YuElvin/stm32_canbus/CANbus_code/Core/Src/main.c

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
/* Includes ------------------------------------------------------------------*/
#include "main.h"
#include "FreeRTOS.h"
#include "cmsis_os2.h"
#include "fatfs.h"
#include "fdcan.h"
#include "lwip.h"
#include "quadspi.h"
#include "sdmmc.h"
#include "usart.h"
#include "gpio.h"

/* USER CODE BEGIN Includes */
#include <stdio.h>
#include <string.h>
#include "FreeRTOS.h"
#include "task.h"
#include "w25qxx.h"
#include "sd_verify.h"
/* USER CODE END Includes */


void SystemClock_Config(void);
static void MPU_Config(void);
void MX_FREERTOS_Init(void);
/**
  * @brief  The application entry point.
  * @retval int
  */
int main(void)
{

  /* USER CODE BEGIN 1 */
  /* Explicitly disable UNALIGN_TRP so that Cortex-M7 handles unaligned
     word access in hardware (Normal memory only). LwIP frequently does
     32-bit access at byte-aligned addresses (IP header in pbuf etc.)
     and we use SMEMCPY override + non-cacheable D2 SRAM, so unaligned
     access must work. */
  SCB->CCR &= ~SCB_CCR_UNALIGN_TRP_Msk;
  __DSB();
  __ISB();
  /* USER CODE END 1 */

  /* MPU Configuration--------------------------------------------------------*/
  MPU_Config();

  /* MCU Configuration--------------------------------------------------------*/

  /* Reset of all peripherals, Initializes the Flash interface and the Systick. */
  HAL_Init();

  /* Configure the system clock */
  SystemClock_Config();

  /* Initialize all configured peripherals */
  MX_GPIO_Init();
  /* MX_FDCAN1_Init(); */     /* Disabled for ETH-only test */
  MX_QUADSPI_Init();
  /* MX_SDMMC1_SD_Init(); */   /* FatFs calls BSP_SD_Init() internally */
  MX_USART2_UART_Init();
  MX_FATFS_Init();
  /* USER CODE BEGIN 2 */
  /* MX_SDMMC1_SD_Init() is commented out to avoid duplicate HAL_SD_Init() call
     (FatFs calls BSP_SD_Init internally). But we still need to set Instance
     and call MspInit so that SDMMC GPIO/clock/PLL are configured. Without
     this, HAL_SD_MspInit's Instance==SDMMC1 check fails and the peripheral
     is left unpowered → NULL pointer dereference in HAL_SD_InitCard.
     Also override BusWide to 1B: 4-bit mode CMD6 always fails on this board
     (D3/PC11 or CMD/PD2 signal quality issue), falling back wastes ~2s every boot. */
  extern SD_HandleTypeDef hsd1;
  hsd1.Instance = SDMMC1;
  hsd1.Init.BusWide = SDMMC_BUS_WIDE_1B;
  /* Force-reset SDMMC1 to clear stale IDMA state from debug resets.
     Without this, a previous session's IDMACTRL/IDMABASE0 may remain
     configured, causing phantom AXI writes → IMPRECISE HardFault. */
  __HAL_RCC_SDMMC1_FORCE_RESET();
  __HAL_RCC_SDMMC1_RELEASE_RESET();
  HAL_SD_MspInit(&hsd1);
  SD_Detect_GPIO_Init();
  /* SD_Verify() must run after FreeRTOS scheduler starts (sd_diskio uses
     RTOS message queue for DMA completion). Moved to a task in freertos.c. */
  /* USER CODE END 2 */

  /* Init scheduler */
  osKernelInitialize();  /* Call init function for freertos objects (in cmsis_os2.c) */
  MX_FREERTOS_Init();

  /* Start scheduler */
  osKernelStart();

  /* We should never get here as control is now taken by the scheduler */

  /* Infinite loop */
  /* USER CODE BEGIN WHILE */
  while (1)
  {
    /* USER CODE END WHILE */

    /* USER CODE BEGIN 3 */
  }
  /* USER CODE END 3 */
}

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
/* USER CODE BEGIN 4 */
extern UART_HandleTypeDef huart2;

static void uart_print(const char *s)
{
  HAL_UART_Transmit(&huart2, (uint8_t *)s, strlen(s), 200);
}

void vAssertCalled(const char *file, uint32_t line)
{
  char buf[80];
  taskDISABLE_INTERRUPTS();
  sprintf(buf, "\r\n[ASSERT] %s:%lu\r\n", file, line);
  uart_print(buf);
  for(;;) {}
}
/* USER CODE END 4 */

 /* MPU Configuration */

void MPU_Config(void)
{
  MPU_Region_InitTypeDef MPU_InitStruct = {0};

  /* Disables the MPU */
  HAL_MPU_Disable();

  /** Initializes and configures the Region and the memory to be protected
  */
  MPU_InitStruct.Enable = MPU_REGION_ENABLE;
  MPU_InitStruct.Number = MPU_REGION_NUMBER0;
  MPU_InitStruct.BaseAddress = 0x30000000;
  MPU_InitStruct.Size = MPU_REGION_SIZE_256KB;
  MPU_InitStruct.SubRegionDisable = 0x0;
  MPU_InitStruct.TypeExtField = MPU_TEX_LEVEL1;
  MPU_InitStruct.AccessPermission = MPU_REGION_FULL_ACCESS;
  MPU_InitStruct.DisableExec = MPU_INSTRUCTION_ACCESS_DISABLE;
  /* Memory attributes: TEX=001, C=0, B=0, S=0 → Normal Outer/Inner Non-Cacheable.
     CubeMX default (TEX=001, C=0, B=1) is "Implementation-defined" per ARMv7-M
     spec, which on STM32H7 behaves Device-like: forbids unaligned access and
     traps cache maintenance ops. Correct Normal-NC encoding requires B=0. */
  MPU_InitStruct.IsShareable = MPU_ACCESS_NOT_SHAREABLE;
  MPU_InitStruct.IsCacheable = MPU_ACCESS_NOT_CACHEABLE;
  MPU_InitStruct.IsBufferable = MPU_ACCESS_NOT_BUFFERABLE;

  HAL_MPU_ConfigRegion(&MPU_InitStruct);

  /** Initializes and configures the Region and the memory to be protected
  */
  MPU_InitStruct.Number = MPU_REGION_NUMBER1;
  MPU_InitStruct.BaseAddress = 0x24000000;
  MPU_InitStruct.Size = MPU_REGION_SIZE_512KB;
  MPU_InitStruct.DisableExec = MPU_INSTRUCTION_ACCESS_ENABLE;
  MPU_InitStruct.IsShareable = MPU_ACCESS_NOT_SHAREABLE;
  MPU_InitStruct.IsCacheable = MPU_ACCESS_CACHEABLE;

  HAL_MPU_ConfigRegion(&MPU_InitStruct);
  /* Enables the MPU */
  HAL_MPU_Enable(MPU_PRIVILEGED_DEFAULT);

}

/**
  * @brief  Period elapsed callback in non blocking mode
  * @note   This function is called  when TIM6 interrupt took place, inside
  * HAL_TIM_IRQHandler(). It makes a direct call to HAL_IncTick() to increment
  * a global variable "uwTick" used as application time base.
  * @param  htim : TIM handle
  * @retval None
  */
void HAL_TIM_PeriodElapsedCallback(TIM_HandleTypeDef *htim)
{
  if (htim->Instance == TIM6)
  {
    HAL_IncTick();
  }
}

/**
  * @brief  This function is executed in case of error occurrence.
  * @retval None
  */
void Error_Handler(void)
{
  /* USER CODE BEGIN Error_Handler_Debug */
  char buf[48];
  __disable_irq();
  sprintf(buf, "\r\n[ERROR_HANDLER] LR=0x%08lX\r\n",
          (uint32_t)__builtin_return_address(0));
  HAL_UART_Transmit(&huart2, (uint8_t *)buf, strlen(buf), 200);
  while (1) {}
  /* USER CODE END Error_Handler_Debug */
}
#ifdef USE_FULL_ASSERT
/**
  * @brief  Reports the name of the source file and the source line number
  *         where the assert_param error has occurred.
  * @param  file: pointer to the source file name
  * @param  line: assert_param error line source number
  * @retval None
  */
void assert_failed(uint8_t *file, uint32_t line)
{
  /* USER CODE BEGIN 6 */
  /* User can add his own implementation to report the file name and line number,
     ex: printf("Wrong parameters value: file %s on line %d\r\n", file, line) */
  /* USER CODE END 6 */
}
#endif /* USE_FULL_ASSERT */
