YuElvin/stm32_canbus/CANbus_code/CANbus_code.ioc

Mcu.UserName=STM32H750VBTx
PA1.Signal=ETH_REF_CLK
PA2.Signal=ETH_MDIO
PA7.Signal=ETH_CRS_DV
PB10.Signal=QUADSPI_BK1_NCS
PB11.Signal=ETH_TX_EN
PB12.Signal=ETH_TXD0
PB13.Signal=ETH_TXD1
PB2.Signal=QUADSPI_CLK
PC1.Signal=ETH_MDC
PC10.Signal=SDMMC1_D2
PC11.Signal=SDMMC1_D3
PC12.Signal=SDMMC1_CK
PC4.Signal=ETH_RXD0
PC5.Signal=ETH_RXD1
PC8.Signal=SDMMC1_D0
PC9.Signal=SDMMC1_D1
PD0.Signal=FDCAN1_RX
PD1.Signal=FDCAN1_TX
PD11.Signal=QUADSPI_BK1_IO0
PD12.Signal=QUADSPI_BK1_IO1
PD13.Signal=QUADSPI_BK1_IO3
PD2.Signal=SDMMC1_CMD
PD5.Signal=USART2_TX
PD6.Signal=USART2_RX
PE2.Signal=QUADSPI_BK1_IO2
PE7.Signal=GPIO_Output
PE8.Signal=GPIO_Output
