YuElvin/stm32_canbus/CANbus_code/Core/Inc/main.h

#define DBG_LED1_Pin            GPIO_PIN_10
#define DBG_LED1_GPIO_Port      GPIOE
#define DBG_LED2_Pin            GPIO_PIN_11
#define DBG_LED2_GPIO_Port      GPIOE
#define SD_DETECT_Pin           GPIO_PIN_8
#define SD_DETECT_GPIO_Port     GPIOA
