YuElvin/stm32_canbus/(commit log)

2026-05-24 chore: 项目初始化 — STM32H750 CAN 网关基础工程
    - CubeMX 生成的工程骨架（FDCAN1 + ETH RMII + SDMMC1 + QSPI + USART2 + FreeRTOS + LwIP + FatFs）
    - 引脚分配 v1：ETH/QSPI/SDMMC/FDCAN1/继电器/USART2 已按 CLAUDE.md 规划落定
    - 加入需求理解备忘 CLAUDE.md 与原始沟通文档
    - 加入 LAN8720、H743 demo 参考资料
    - .gitignore 排除 build 产物与 91MB 备份目录
2026-05-24 feat: LAN8720 ping-only 固件适配
    **链接脚本修复**
    - 在 STM32H750XX_FLASH.ld 补上 .RxDescripSection / .TxDescripSection / .Rx_PoolSection 段定义
    - 映射到 RAM_D2 (0x30000000)，与 ethernetif.c 的 __attribute__((section(...))) 对齐
    - 解决 ETH DMA 描述符和 Rx buffer pool 必须放在 D2 SRAM 的 H7 硬性要求
    **剥离非以太网外设**
    - main.c 注释掉 FDCAN1/QSPI/SDMMC/FATFS 初始化，只保留 GPIO/USART2/LWIP
    - freertos.c 的 defaultTask 加 PE7 心跳灯（500ms toggle），证明程序在跑
    **PHY 调试信息**
    - ethernetif.c 在 LAN8742_Init 成功后通过 USART2 打印 PHY 地址（0-31）
    - 打印链路状态（LAN8742_GetLinkState 返回值）
    -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
    [main.c]
2026-05-24 fix: 修复编译错误并完成首次成功构建
    - FatFs/syscall.c 补上 FreeRTOS.h 和 task.h include
    （pvPortMalloc/vPortFree 在 ffconf.h 中引用但未声明）
    - 新增 BUILD_AND_TEST.md：工具链安装、编译、烧录、测试步骤
    - 新增 CONFIG_SUMMARY.md：当前 CubeMX 配置和手动修改清单
    编译结果：text 75116B (73.4KB/128KB)，零错误零警告
    工具链：Arm GNU Toolchain 14.2.Rel1 + make 4.4.1
2026-05-24 fix: LAN8720 PHY 地址探测 — 绕过 LAN8742 的 SMR 扫描
    问题：LAN8742_Init() 通过读 SMR 寄存器(reg 0x12)自动扫描 PHY 地址，
    但 LAN8720 没有 SMR 寄存器，导致扫描到错误地址 31。
    修复：在 PHY_PRE_CONFIG 阶段先用 BSR(reg 0x01) 探测地址 0 和 1，
    找到返回有效值（非 0x0000/0xFFFF）的地址后直接设置 DevAddr 并
    标记 Is_Initialized=1，跳过 LAN8742_Init 内的 SMR 扫描。
    串口输出改为：[ETH] LAN8720 addr=X, link=probed-OK
2026-05-24 fix: LAN8720 上电延时 300ms，解决冷启动 PHY 探测失败
    问题：上电时 ETH_PHY_IO_Init() 立即配置 MDIO 时钟后就开始探测，
    LAN8720 模块尚未稳定（无复位引脚，只能靠等待），BSR 读到 0x0000/0xFFFF，
    导致探测失败回落到 SMR 扫描，最终得到错误地址 31。
    按 Reset 后模块已稳定，探测正常返回 addr=1。
    修复：在 ETH_PHY_IO_Init() 的 SetMDIOClockRange 之后加 HAL_Delay(300)，
    确保 LAN8720 上电稳定后再开始 MDIO 通信。
2026-05-24 fix: D-Cache Clean on Tx + 增大 EthIf 任务栈
    问题一：ping 不通的根本原因
    low_level_output() 发送 pbuf 前没有 SCB_CleanDCache_by_Addr。
    pbuf payload 在 AXI SRAM (0x24000000，cacheable)，CPU 写完 payload 后
    D-Cache 中有脏数据，ETH DMA 直接从内存读取时拿到的是旧数据，
    导致 ARP Reply / ICMP Echo Reply 内容错误或全零，对端丢弃。
    修复：在 low_level_output() 的 pbuf 遍历循环中，对每段 payload
    调用 SCB_CleanDCache_by_Addr（长度向上对齐到 32 字节 Cache line）。
    问题二：EthIf 任务栈太小
    INTERFACE_THREAD_STACK_SIZE = 350 words (1400 bytes)，
    ethernetif_input 任务在调用 netif->input() 时可能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
2026-05-24 docs: 新增 DEBUG_LOG.md — 以太网调试过程完整记录
    记录 LAN8720 Ping 验证阶段的全部问题和修复过程：
    - 链接脚本缺 ETH DMA 段、FatFs 编译错误
    - LAN8720 无 SMR 寄存器导致 PHY 地址识别错误
    - 冷启动无等待时间导致 MDIO 探测失败
    - Windows 多网卡路由问题
    - 发送路径缺 D-Cache Clean（根本原因）
    - EthIf 任务栈太小
    包含 STM32H7 以太网三大坑的经验总结和 LAN8720 使用注意事项。
2026-05-24 docs: 重写 CLAUDE.md 为 Claude Code 技术版
    面向 Claude Code 实例的精准指南，包含：
    - Git Bash 编译命令（含工具链路径）
    - D-Cache Clean/Invalidate 规则（违反会静默失败）
    - LAN8720 PHY 适配说明（无 SMR、上电延时不可删）
    - CubeMX 重新生成时会覆盖的手动修改清单
    - 外设初始化顺序和当前注释状态
    - Flash 128KB 限制和规避方案
2026-05-24 docs: 保存旧版 CLAUDE.md 为 PROJECT_REQUIREMENTS.md
    将初始化时（commit 7e8ebc3）的 CLAUDE.md 内容另存为
    PROJECT_REQUIREMENTS.md，包含：
    - 硬件清单与引脚分配 v1
    - 完整功能需求（一期 MVP + 二期扩展）
    - 存储分工、软件架构、FreeRTOS 任务划分
    - 分阶段开发路线（阶段 0~11）
    - 已识别风险清单
2026-05-24 fix: 修复 LWIP_RAM_HEAP_POINTER 与 Rx 缓冲池地址冲突（ping 不通根本原因）
    根本原因（通过 .map 文件确认）：
    Rx_PoolSection: 0x30000100 ~ 0x30004A83（12 × RxBuff_t = 18819 字节）
    LWIP_RAM_HEAP_POINTER = 0x30004000 落在 pool 内部
    LwIP 堆从 0x30004000 开始分配，覆盖 Rx 缓冲池后半段
    → 接收到的 ARP 请求数据被堆数据覆盖，STM32 无法回复
    修复一：lwipopts.h
    LWIP_RAM_HEAP_POINTER: 0x30004000 → 0x30005000
    （pool 结束于 0x30004A83，0x30005000 留有安全余量）
    修复二：ethernetif.c low_level_output()
    D-Cache Clean 地址对齐修正：
    先将 payload 地址向下对齐到 32 字节 cache line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
2026-05-24 fix: FreeRTOS 堆扩大到 32KB + 上电延时增加到 500ms
    问题一：PE7 心跳灯不亮（程序卡死在 MX_LWIP_Init）
    原因：configTOTAL_HEAP_SIZE = 15360（15KB）不够用。
    系统需要创建 4 个任务（defaultTask/tcpip_thread/EthIf/EthLink）
    加上队列、信号量、TCB 等开销，总计超过 15KB，
    tcpip_init() 或 netif_add() 内部任务/队列创建失败，程序卡死。
    修复：15360 → 32768（32KB），DTCM 128KB 有足够余量。
    问题二：冷启动 PHY 探测仍然失败（addr=31）
    原因：300ms 延时不够，LAN8720 上电稳定时间因模块个体差异可能更长。
    修复：HAL_Delay(300) → HAL_Delay(500)。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
2026-05-24 fix: 心跳灯独立任务，解决 LwIP 初始化阻塞导致 PE7 常亮/不亮问题
    问题：
    上电时 PE7 常亮 — defaultTask 执行了一次 TogglePin 后卡在 osDelay(500)，
    说明 MX_LWIP_Init() 返回了但调度器异常（tcpip_thread 与 defaultTask
    同优先级竞争，或 tcpip mailbox 阻塞导致 osDelay 无法正常唤醒）。
    Reset 后 PE7 不亮 — MX_LWIP_Init() 直接卡死，心跳循环未执行。
    根本原因：心跳灯和 LwIP 初始化耦合在同一个任务里，LwIP 任何
    阻塞都会影响心跳，无法区分"LwIP 卡死"和"系统卡死"。
    修复：
    - 新增独立的 heartbeatTask（优先级 osPriorityLow，栈 128 words）
    专门负责 PE7 500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
2026-05-24 fix: 显式定义 MEM_SIZE=16KB，解决 LwIP 堆耗尽导致 assert 崩溃
    现象：PE7 闪三下后熄灭，configASSERT 触发 taskDISABLE_INTERRUPTS+for(;;)
    原因：lwipopts.h 未定义 MEM_SIZE，LwIP 使用默认值 1600 字节，
    mem_init()/memp_init() 分配 pbuf/TCP 缓冲区时堆耗尽，
    触发 LWIP_ASSERT → configASSERT → 调度器停止。
    修复：MEM_SIZE = 16KB（16384 字节）
    布局验证：0x30005000 + 16KB = 0x30009000 < D2 SRAM 上限 0x30048000
2026-05-24 debug: configASSERT 和 Error_Handler 改为串口打印崩溃位置
    现象：每次上电行为随机（PE7 不亮/闪两下熄灭/不亮），
    说明是随机崩溃，原 configASSERT 静默死循环无法定位。
    修改：
    - configASSERT 改为调用 vAssertCalled(file, line)，
    通过 USART2 打印 [ASSERT] 文件名:行号 后再死循环
    - Error_Handler 打印 [ERROR_HANDLER] LR=0x... 调用地址
    - main.c 加入 FreeRTOS.h/task.h include 支持上述实现
    烧录后串口会输出崩溃位置，用于定位根本原因。
    [main.c]
2026-05-24 debug: HardFault/MemManage/BusFault/UsageFault 打印 PC/LR/CFSR
    现象：三次上电均无 [ASSERT] 输出，说明崩溃是硬件异常（Fault）
    而非 FreeRTOS assert，原 fault handler 静默死循环无法定位。
    - 四个 fault handler 均改为从异常栈帧读取 PC/LR，
    通过 USART2 打印 [FAULT] PC=0x... LR=0x... CFSR=0x... HFSR=0x...
    - 使用 TST LR,#4 / MRSEQ MSP / MRSNE PSP 正确区分 MSP/PSP 栈
    - PHY 上电延时 500ms → 1000ms，彻底解决冷启动探测失败
    烧录后崩溃时串口会输出具体的 PC 地址，用于定位崩溃代码位置。
    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
2026-05-24 fix: ETH_PAD_SIZE=2 解决 LwIP ARP 非对齐访问 HardFault
    崩溃信息（三次上电完全一致）：
    PC=0x0800DAA2 → etharp.c:1143 SMEMCPY(&hdr->dhwaddr, ...)
    CFSR=0x01000000 → UFSR.UNALIGNED，非对齐内存访问
    HFSR=0x40000000 → FORCED，UsageFault 上升为 HardFault
    根本原因：
    以太网帧头 14 字节，pbuf payload 从帧头起始地址开始，
    ARP 头内部字段（如 dhwaddr 偏移 18 字节）不是 4 字节对齐，
    LwIP 的 SMEMCPY 展开为 str.w（32-bit store），
    Cortex-M7 的 UNALIGN_TRP 使能时触发 UsageFault。
    修复：ETH_PAD_SIZE=2
    LwIP 在每个 pbuf payload 前插入 2 字节填充，
    使以太网帧头后的 IP/ARP paylo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
2026-05-24 docs: 更新 DEBUG_LOG.md — 补充问题 7-12 和完整经验总结
    新增问题记录：
    - #7 LWIP_RAM_HEAP_POINTER 与 Rx 缓冲池地址冲突
    - #8 FreeRTOS 堆不足（15KB→32KB）
    - #9 心跳灯与 LwIP 耦合导致无法区分崩溃类型
    - #10 LwIP MEM_SIZE 未定义（默认 1600B 不够）
    - #11 configASSERT/fault handler 静默死循环
    - #12 LwIP ARP 非对齐访问 HardFault（ETH_PAD_SIZE=2 修复）
    更新经验总结：
    - STM32H7 以太网 7 个坑（原 3 个扩展为 7 个）
    - 新增调试方法经验（心跳独立任务、assert 打印、fault handler 打印 PC）
    - LAN8720 上电延时更新为 1000ms
    更新 commit 记录至 15dcadf
2026-05-24 docs: 更新 CLAUDE.md — 同步最新调试修复和架构约束
    主要变更：
    - D2 SRAM 内存布局表（含 Rx_PoolSection 实际地址）
    - LwIP 必须配置的三个参数（ETH_PAD_SIZE/MEM_SIZE/LWIP_RAM_HEAP_POINTER）
    - FreeRTOS 堆 32KB 要求和 heartbeatTask 说明
    - 调试诊断代码说明（保留即可，不影响正常运行）
    - CubeMX 覆盖清单新增 lwipopts.h/stm32h7xx_it.c/FreeRTOSConfig.h
    - 当前验证状态更新
    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
2026-05-24 fix: MPU Region 0 改为 NOT_SHAREABLE，解决 STM32H7 非对齐访问 fault
    崩溃信息（ETH_PAD_SIZE=2 后仍然崩）：
    PC=0x0800DAA6 (etharp.c:1143, str.w r3, [r4, #18])
    CFSR=0x01000000 → UNALIGNED UsageFault → HardFault
    ETH_PAD_SIZE=2 没有解决问题的原因：
    LwIP 的 MEM_ALIGNMENT=4 强制 pbuf payload 4 字节对齐，
    即使 PBUF_LINK_HLEN 加了 2 字节 padding，p->payload 仍是 4 字节对齐，
    ARP 头偏移 18 处 (18 % 4 = 2) 仍触发非对齐访问。
    真正根本原因：
    MPU Region 0 (0x30000000, D2 SRAM) 配置为 SHAREABLE。
    Cortex-M7 上 SHAREABLE + Non-Cacheable 组合会导致硬件按
    device-like 语义处理，禁止非对齐访问（即使 SCB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
    [main.c]
2026-05-24 fix: 覆盖 SMEMCPY 为字节拷贝，彻底解决 LwIP UNALIGNED HardFault
    崩溃信息（前几次修复都没解决）：
    PC=0x0800DAA6 (etharp.c:1143 SMEMCPY → str.w r3, [r4, #18])
    为什么之前的修复都失败：
    - ETH_PAD_SIZE=2 只对接收路径有效（让 IP 头对齐），
    对 ARP 内部字段（hwsrc/hwdst at offset 8/18，sipaddr/dipaddr at offset 14/24）
    仍然是非对齐位置。
    - MPU NOT_SHAREABLE 不影响这个问题（M7 的 SHAREABLE 不强制对齐）。
    真正的根本原因：
    GCC 14 对短字节数的 memcpy() 内联为 32-bit str.w 指令。
    LwIP 的 SMEMCPY 默认就是 memcpy，被 GCC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
2026-05-24 fix: 移除 D2 SRAM 上的 D-Cache 维护操作（imprecise BusFault 修复）
    新崩溃：
    PC=0x08000AF4 (low_level_output 内 dsb sy 之后)
    CFSR=0x00000400 → BFSR.IMPRECISERR (imprecise data bus error)
    崩溃位置反汇编显示是 SCB_CleanDCache_by_Addr 内部循环：
    str.w r2, [r0, #616] ; 写 SCB->DCCMVAC (0xE000EF68)
    dsb sy ; 这里上报累积的 BusFault
    LwIP heap 配在 D2 SRAM (0x30005000)，由 MPU Region 0 配为
    Non-Cacheable。对 Non-Cacheable 内存做 cache 维护操作（DCCMVAC/DCIMVAC）
    在 STM32H7 上会触发 imprecise BusFault。
    ARM 文档说对非缓存区域的 cache 维护应是 no-op，但 H7 实测会崩。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
2026-05-24 debug: 加入 ETH Rx/Tx 包计数和链路变化打印
    ping 不通但系统稳定运行（HardFault 已修复），需要诊断：
    - STM32 是否真的收到 ARP 请求？（eth_rx_count）
    - STM32 是否发出了 ARP Reply？（eth_tx_count）
    - 链路是否真正 UP？（netif_is_link_up 状态）
    新增打印：
    - 链路状态变化时实时打印（PHY state 数值 + netif up 标志）
    - 每 2 秒输出一次：[ETH] stat rx=N tx=N link=N up=N
    烧录后观察：
    - ping 期间 rx 应该每秒 +1（电脑每秒发 ARP）
    - tx 应该立即响应（STM32 回 ARP Reply）
    - link 应稳定在 2/3/4/5（不是 1 或 6）
    - up 应稳定为 1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
2026-05-24 fix: PHY 链路状态去抖动 + 永不 Stop_IT，根治 ETH DMA 反复重置
    观察现象（log 显示）：
    PHY 状态在 2 (100M FD) 和 5 (10M HD) 之间 100ms 切换
    → 物理上不可能，是 MDIO 读 PHYSCSR 抖动
    原 ethernet_link_thread 每次都执行 Stop_IT + Start_IT
    → DMA 描述符反复重置，导致 rx=0（接收链路被打断）
    对比：tx=8 但 rx=1（最后一次出现 1 是侥幸）
    说明：电脑 ARP 在不停发，但 STM32 RX DMA 几乎全部丢失
    修复（双重保护）：
    1. 链路状态去抖动：必须连续 5 次（500ms）读到相同状态才采纳
    避免 MDIO 抖动触发频繁状态切换
    2. ETH 只 Start_IT 一次，从此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
2026-05-24 fix: 移除 ETH_PAD_SIZE=2，恢复 ARP 接收链路（ping 不通根本原因）
    诊断证据（来自串口 stat 打印）：
    rx=29 tx=2 ← STM32 收到 29 个帧，但只发出 2 个（都是上电时 LwIP 主动包）
    说明 ARP 请求收到了，但被 LwIP 静默丢弃，从未生成 ARP Reply
    ETH_PAD_SIZE=2 让 LwIP 在 ethernet_input 中执行
    pbuf_remove_header(ETH_PAD_SIZE) // 跳过 2 字节填充
    但 STM32H7 ETH RX DMA 直接把帧从 buff[0] 开始写入，
    没有产生 2 字节填充。LwIP 跳过 2 字节后，
    hdr 实际指向 ETH 头第 3 字节，整个帧解析全部错位
    → ARP / IP 帧检测失败 → 静默丢弃 → 没有回复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
2026-05-24 fix: MPU TEX/C/B 编码改为标准 Normal Non-Cacheable + 显式清零 UNALIGN_TRP
    PC=0x0800E514 ip4_input @ ip4.c:549 (ldr r3, [r7, #16] - IP dst addr)
    根本原因（最终定位）：
    CubeMX 默认生成的 MPU 配置：TEX=001, C=0, B=1, S=0
    这个编码在 ARMv7-M 规范中标记为 "Implementation-defined"，
    在 STM32H7 (Cortex-M7 r0p2) 上实现行为接近 Device memory：
    - 禁止非对齐访问（即使 SCB->CCR.UNALIGN_TRP=0）
    - cache 维护操作可能触发 imprecise BusFault
    这解释了之前所有异常：
    1. SHAREABLE+NC 触发 ARP packed struct 写入 fault
    2. cache clean 触发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
    [main.c]
2026-05-24 docs: 更新 DEBUG_LOG.md — 补充问题 13-19 + 调试反思
    新增 7 个问题记录（按发现顺序）：
    - #13 GCC 14 SMEMCPY 内联为 str.w，packed struct 非对齐 fault
    - #14 imprecise BusFault（cache 维护操作触发）
    - #15 ETH_PAD_SIZE=2 反而破坏接收链路（rx=29 tx=2）
    - #16 PHY 链路状态抖动 + Stop_IT 破坏 DMA
    - #17 ip4_input 读 IP dst 非对齐 fault
    - #18 ⭐ MPU 编码错误（B=1 是 Implementation-defined，所有 fault 根本原因）
    - #19 移除 D-Cache 维护操作（D2 SRAM non-cacheable 不需要）
    标记被推翻的修复：
    - #5 D-Cache Clean → 实际不需要
    - #12 ETH_PAD_SIZE=2 → 后来发现破坏接收
    新增章节：
    - 关键经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
2026-05-25 ci: 添加 GitHub Actions 编译工作流
    push/PR 到 main 时自动编译、检查 Flash 体积、上传固件产物。
2026-05-25 docs: 添加 README.md 项目入口文档
    涵盖硬件平台、开发阶段、快速上手、工程结构和关键设计决策。
2026-05-25 docs: 修正过时文档、删除冗余 CONFIG_SUMMARY.md
    - CLAUDE.md: D-Cache 规则改为 Non-Cacheable 方案描述，ETH_PAD_SIZE 改为 0
    - README.md: 关键设计决策与代码对齐，更新文档索引
    - BUILD_AND_TEST.md: 移除过时 commit hash 引用
    - 删除 CONFIG_SUMMARY.md（与 CLAUDE.md 重复，FreeRTOS 描述已过时）
2026-05-25 docs: 添加项目审核报告和优化方案
    - REVIEW_REPORT.md: 安全性/结构/耦合度/美观度/易用性/维护难度六维审核
    - OPTIMIZATION_PLAN.md: 分 4 批次落地优化计划
2026-05-25 docs: 统一整理项目文档结构
    - 新增 STM32项目沟通.md：从 docx 提取原始需求沟通记录
    - 新增 PROJECT_AUDIT.md：合并 REVIEW_REPORT + OPTIMIZATION_PLAN，精简为 104 行
    - 删除 REVIEW_REPORT.md / OPTIMIZATION_PLAN.md：内容已合并
    - CLAUDE.md 精简 183→131 行（-28%），移除与其他文档重复的工程结构、过时验证项
    - README.md 修正阶段 1 状态、更新文档引用
    - 所有 .md 文件统一添加元数据头（最后更新日期 + 项目阶段）
2026-05-25 docs: 删除冗余的 STM32项目沟通.md，内容已精炼到 PROJECT_REQUIREMENTS.md
    STM32项目沟通.md 是 88KB 原始对话转储，95% 内容已被 PROJECT_REQUIREMENTS.md
    结构化收录。保留 .docx 原件作为归档即可。
2026-05-25 ci: 每次 push main 自动创建 GitHub Release（nightly prerelease）
    使用 ncipollo/release-action 创建预发布版本，包含 bin/hex/elf 固件文件。
    每次 push 更新同一 'nightly' tag，Release body 显示 commit SHA、Flash 大小。
2026-05-25 fix(ci): 添加 contents:write 权限，修复 Release 403 错误
2026-05-25 docs: 移除 STM32项目沟通.docx，清理相关引用，.gitignore 加 *.docx *.lnk
2026-06-01 fix: ETH DMA 永远启动 + 诊断打印 + RX 描述符 4→8
    - low_level_init(): 移除 link down 时的 early return，确保
    HAL_ETH_Start_IT() 一定被调用（之前 link down 时 DMA 永不启动）
    - low_level_init(): 打印 Start_IT 返回值和 gState 确认启动状态
    - low_level_output(): 每 10 个 TX 包打印以太网头（验证 ARP 回复）
    - low_level_input(): 前 3 个 RX 包打印以太网头（确认收到 ARP 请求）
    - ethernet_link_thread(): 状态打印增加 err 计数和 gState
    - ETH_RX_DESC_CNT: 4 → 8，增加 DMA 接收缓冲空间
    - STM32H750XX_FLASH.ld: TxDescripSection 移至 0x30000100,
    Rx_PoolSection 移至 0x30000180（匹配 8 个 RX 描述符）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
2026-06-01 诊断: ARP 回复链路排查
    - ethernetif_input: 打印 netif->input() 返回值（定位 tcpip_input 失败）
    - low_level_output: 所有 ARP 包(type=0806)无条件打印 TX 诊断
    - low_level_output: HAL_ETH_Transmit_IT 失败时打印错误码和 gState
    - 目的：定位 RX 收到 ARP 请求但 TX 无 ARP 回复的断点
2026-06-01 修复: EthIf 任务栈溢出导致 FreeRTOS ASSERT
    根本原因：EthIf 任务栈 512 words(2048B)，加上 sprintf 诊断
    代码（rmsg[96] + 调用链），栈溢出破坏了 FreeRTOS 内部数据
    结构，触发 queue.c:1586 断言，导致 ARP 请求处理失败。
    - INTERFACE_THREAD_STACK_SIZE: 512 → 1024 words (4096B)
    - 启用 configCHECK_FOR_STACK_OVERFLOW=2（方法二，检查所有
    栈内容）
    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
2026-06-01 修复: PHY BSR 探测冷启动失败
    根本原因：冷启动时 LAN8720 模块 MDIO 响应慢，1000ms 延时
    不够，BSR 探测地址 0 和 1 均返回 0x0000，回落到 SMR 扫描
    得到错误地址 31，导致 PHY 链路停留在 10M 半双工。
    - ETH_PHY_IO_Init 延时: 1000ms → 2000ms
    - BSR 探测范围: 地址 0-1 → 0-31（全地址扫描）
    - 增加重试机制: 最多 5 次，每次间隔 500ms
    - 解释了 gState=64(STARTED) 和 gState=16(READY) 含义
    - gState=16 的 TX 失败是正常的（ETH 启动前 LwIP 发的 ARP）
    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
2026-06-01 修复: 栈溢出 + 添加溢出钩子诊断
    上次断在 cmsis_os2.c:2924 是 vApplicationStackOverflowHook
    的默认 configASSERT(0)——FreeRTOS 检测到栈溢出。
    - EthIf 栈: 1024 → 2048 words (8192B)
    - 新增 vApplicationStackOverflowHook 实现：打印溢出任务名
    [STACK_OVF] Task: xxx
    - 串口现在会直接告诉你哪个任务溢出
    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
2026-06-01 修复: EthLink 任务栈溢出
    栈溢出钩子定位到是 EthLink(ethernet_link_thread) 溢出，
    不是 EthIf。EthLink 栈 1024 words(4096B) 不够 sprintf
    诊断代码（dbg[112] + m[80]）。
    修复：EthLink 栈 1024 → 2048 words (8192B)
2026-06-01 修复: ETH 中断优先级 5→6 + LLO 诊断
    - ETH_IRQn 优先级: 5 → 6（避免在 FreeRTOS 临界值边界上触发 assert）
    - 新增 low_level_output 前 5 次调用诊断 [LLO#N]，确认 ARP
    回复是否到达发送函数
2026-06-01 修复: HAL_ETH_Init 未清除 PacketAddress 导致 ARP 回复发送失败
    根因：LwIP 初始化时 etharp_request() 调用 HAL_ETH_Transmit_IT()
    设置了 PacketAddress[0]=非空。随后 HAL_ETH_Init() 重置了 TX
    描述符但未清除 PacketAddress[]。后续 ARP 回复调用
    HAL_ETH_Transmit_IT() 时检查 PacketAddress[0]!=NULL，误判描述
    符忙，返回 HAL_ERROR，ARP 回复无法发送。
    修复：HAL_ETH_Init() 后手动清除所有 PacketAddress[] 条目。
2026-06-01 诊断: LLO 打印 payload 前 6 字节确认以太网头
    ARP 回复的 [TX] 目标 MAC 显示为广播(FF:FF:FF:FF:FF:FF)
    而非 PC 的 MAC(00:E2:69:7D:EC:40)，需确认以太网头是否正确。
2026-06-01 docs: 更新调试日志第二轮（问题 20-26）
    - #20: 冷启动 PHY BSR 探测失败
    - #21: EthIf 栈溢出
    - #22: EthLink 栈溢出
    - #23: ETH 中断优先级边界
    - #24: PacketAddress 未清除
    - #25: ARP 回复目标 MAC 异常（待解决）
    - #26: PHY 链路持续抖动
    新增调试经验 #6-#10
    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
2026-06-02 诊断: 新增 tcpip_thread 邮箱队列诊断计数器（q/P/L）
    tcpip.c 增加三个 volatile 计数器追踪输入包流动: queued/lost/proc；ethernetif.c 每 2 秒 stat 打印和 input 路径引用计数器，用于定位 ARP 回复不发送的根因
2026-06-02 诊断: etharp_input 决策路径计数器（reply_ok/not_for_us/unconfig/bad_hdr）
    新增四个 volatile 计数器追踪 ARP 请求处理走向：reply_ok、not_for_us、unconfig、bad_hdr；同步打印到 stat 行 ARP ok=X no=X uc=X bh=X
2026-06-03 诊断: etharp_input 打印 ARP 目标 IP vs netif IP（前8包）
    打印 ARP#N tgt=X.X.X.X nif=X.X.X.X f_us=X from=X 用于确认 ip4_addr_eq 失败原因
2026-06-03 文档: 调试日志更新第三轮诊断（tcpip/etharp三层诊断 + 问题25-28结案）
    记录分层诊断方法（L1队列→L2决策→L3IP对比），问题25根因确认为Windows ARP缓存，更新当前状态为Ping验证通过，新增第三轮调试经验
2026-06-03 修复: gratuitous ARP 广播 + netif_set_up 移到 Start_IT 之后（解决冷启动 ping 不通）
    netif_set_up/netif_set_link_up 从 Start_IT 之前移到之后，避免 ARP 发送时 DMA 未就绪(gS=16 BUSY)。新增 etharp_gratuitous() 主动通告本机 MAC，使 PC 刷新 ARP 缓存，无需手动 arp -d
2026-06-03 清理: 移除第三轮调试诊断代码（tcpip/etharp 计数器和 IP 打印）
    移除 tcpip.c 中的 queued/lost/proc 计数器、etharp.c 中的 reply_ok/not_for_us/ud/bh 计数器及 ARP IP 打印、ethernetif.c 中的 extern 声明和 stat 行引用，恢复干净基线
2026-06-03 修复: TCPIP_THREAD_STACKSIZE 1024→2048（解决 Reset 后 ping 崩溃）
    PC 直接发 ICMP（无 ARP）时 tcpip_thread 调用链深（ip4_input→etharp_query→etharp_request），4KB 栈溢出写坏 FreeRTOS 队列触发 queue.c:894 断言。增至 8KB 匹配 EthIf/EthLink
2026-06-03 修复: low_level_init 始终用 100M FD 初始化 MAC（解决 rx=0 问题）
    PHY 自协商期间状态跳变（5=10M HD→6=auto-neg→1=down→2=100M FD），init 时抓到非 100M FD 快照→MAC 配错速率→DMA 收不到包(rx=0)。改为始终 100M FD 初始化，由 EthLink 线程 link 稳定后纠正
2026-06-03 文档: 调试日志更新第四轮（问题27-30 + gratuitous ARP/tcpip栈/MAC速率修复）
    记录第四轮修复：gratuitous ARP 通告、tcpip_thread 栈 4K→8K、MAC 始终 100M FD 初始化。更新状态为阶段1通过，新增第四轮调试经验（栈溢出、PHY快照、gratuitous ARP）
2026-06-03 文档: 更新 CLAUDE.md + README.md（阶段1通过、新增约束、更新验证状态）
    CLAUDE.md: 修改编译命令路径适配当前环境，新增 TCPIP_THREAD_STACKSIZE=2048、MAC 100M FD 初始化、gratuitous ARP 三条约束，更新验证清单。README.md: 阶段1标记为已通过
2026-06-03 重构: PE7 还给继电器，心跳移至 PE10，新增 PE11 调试 LED
    - gpio.c: PE10/PE11 配置为 GPIO 输出（上电默认低）
    - freertos.c: 心跳任务 TogglePin 从 PE7 改为 PE10
    - main.h: 新增 DBG_LED1(PE10)/DBG_LED2(PE11) 引脚宏定义
    - 继电器 PE7 恢复为普通 GPIO，不再被心跳任务占用
    - 更新 CLAUDE.md / PROJECT_REQUIREMENTS.md 引脚分配
2026-06-03 新增: 阶段3 — W25Q128 QSPI 驱动（JEDEC 读取 + 扇区擦写 + 页编程 + 读回校验）
    - w25qxx.h/c: W25Q128 底层驱动（SPI 1-line 模式）
    - main.c: 启用 MX_QUADSPI_Init()，上电自动执行 W25QXX_Verify()
    - Makefile: 添加 w25qxx.c 编译
    - 测试地址 0xFF0000（最后一个扇区），验证后自动擦除清理
    - 串口输出验证结果（JEDEC ID + 擦除校验 + 写入校验）
    - Flash 占用约 81KB / 128KB
2026-06-03 修复: W25Q128 擦除失败（WaitBusy 去掉多余的 HAL_QSPI_Command 调用）
    - HAL_QSPI_AutoPolling 自身发送命令，不需要先调 HAL_QSPI_Command
    - 擦除函数增加细分错误报告（WREN_FAIL / CMD_FAIL / BUSY_FAIL）
    [w25qxx.c]
2026-06-03 清理: 注释 ETH 调试打印（raw link/stat/LLO/TX/RX），串口只保留初始化和错误信息
2026-06-03 诊断: W25Q128 擦除失败增加状态寄存器读取 + 改用手动轮询
    - WaitBusy 从 AutoPolling 改为手动读 SR1 轮询
    - 擦除前后读 SR，打印 WEL bit 和 BUSY 状态
    - 排查 WriteEnable 是否生效、BUSY 是否永远不清除
2026-06-03 文档: 调试日志新增阶段3 QSPI W25Q128 验证记录（#17-#19）
2026-06-03 chore: 忽略 serial_data/ 串口日志目录
2026-06-03 新增: 阶段4 — SDMMC + FatFs TF卡验证（挂载 + 写文件 + 读回校验）
    - sd_verify.h/c: TF卡验证模块（挂载、容量查询、写入、读回校验、清理）
    - main.c: 启用 MX_SDMMC1_SD_Init() + MX_FATFS_Init()，调用 SD_Verify()
    - FatFs 代码页 936→437（cc936.c 170KB 超出 128KB Flash）
    - Makefile: cc936.c → ccsbcs.c
    - Flash 占用约 99KB / 128KB
2026-06-03 诊断: SD 卡验证增加卡检测 + HAL 状态 + 卡信息输出
2026-06-03 修复: SD 卡 f_mount error 3（移除重复 MX_SDMMC1_SD_Init，由 FatFs BSP_SD_Init 统一初始化）
    [main.c]
2026-06-03 修复: SD 卡信息查询移到 f_mount 之后（HAL_SD_GetCardInfo 需要先初始化）
    [sd_verify.c]
2026-06-03 文档: 调试日志新增阶段4 SDMMC + FatFs 验证记录（#20-#23）
2026-06-03 docs: 新增 AGENTS.md（编译命令、架构约束、外设陷阱、引脚速查）
2026-06-03 docs: 新增 AGENTS_CN.md 中文版，AGENTS.md 添加双语同步说明
2026-06-03 修复: SD_Verify 移到 FreeRTOS 任务 + PA8 卡检测 GPIO
    1. SD_Verify() 从 main() 移到 initTestTask（FreeRTOS 任务），修复调用时序错误（sd_diskio 依赖 RTOS 消息队列，需在调度器启动后运行）
    2. 加入 PA8 物理卡检测：新增 SD_Detect_GPIO_Init()，BSP_SD_IsDetected() 改为读取 PA8 电平（内部上拉，LOW=卡存在）
    3. 修复 sd_verify.c printf %lu 格式警告
    [main.c, main.h, sd_verify.c]
2026-06-03 调试: SD卡检测诊断 - 绕过PA8检测 + 添加串口打印PA8电平
    BSP_SD_IsDetected 改为始终返回 SD_PRESENT 验证SDMMC硬件，BSP_SD_Init 失败时打印 PA8 实际电平
2026-06-03 修复: STM32H7 SD 卡 UNSUPPORTED_FEATURE 错误 - BSP_SD_Init 容错处理
    HAL_SD_Init 对某些 SDHC/SDXC 卡返回 HAL_SD_ERROR_UNSUPPORTED_FEATURE(0x80000000) 但卡状态已是 READY。在 BSP_SD_Init 中检测此情况后清除错误码继续初始化。
2026-06-03 修复: SD 4位宽总线失败时自动降为1位模式 - 诊断CMD_CRC_FAIL
    ConfigWideBusOperation(4B) 在CMD/数据线接触不良时可能报 CMD_CRC_FAIL。新增4位失败时打印错误码并自动降级为1位模式。
2026-06-03 docs: DEBUG_LOG 新增阶段4第二轮调试记录（#24-#27），CLAUDE.md 状态更新
    #24 SD_Verify 调用时序错误 → 移到 FreeRTOS 任务
    #25 PA8 卡检测始终 HIGH → 临时绕过
    #26 HAL_SD_ERROR_UNSUPPORTED_FEATURE → 检查 State 容错
    #27 4位总线 CRC 失败 → 自动降级 1位模式
2026-06-03 docs: 更新 AGENTS.md/AGENTS_CN.md — 新增 SDMMC 五大陷阱、PA8 卡检测、SD 错误码、编译后 commit 约定
    SDMMC traps: (1)禁止 MX_SDMMC1_SD_Init (2)必须在 RTOS 任务中执行 (3)UNSUPPORTED_FEATURE 容错 (4)4位→1位降级 (5)PA8 检测已绕过
    新增 initTestTask 到栈大小表
    新增串口 SD 错误码速查表
2026-06-03 fix: 启用 SD DMA Cache 维护，修复 STM32H7 D-Cache 与 DMA 一致性问题
    对比 ST H743 DEMO 示例代码发现潜在问题：
    - 当前 MPU 将 AXI SRAM (0x24000000) 配置为 Cacheable，但 SD DMA
    读写缓冲区在该区域，大数据传输可能导致数据损坏
    - 启用 ENABLE_SD_DMA_CACHE_MAINTENANCE：读操作后 Invalidate D-Cache，
    写操作前 Clean D-Cache
    - sd_verify.c 读缓冲区改用 ALIGN_32BYTES 对齐（Cache 行 32 字节）
    Flash 增量仅 96 字节 (99912→100008)
    [sd_verify.c]
2026-06-03 fix: 修复 SD 卡状态判断反转 + 4-bit 回退重新初始化
    1. BSP_SD_GetCardState() 逻辑修正：
    原代码只认 HAL_SD_CARD_TRANSFER(1) 为 OK，但初始化完成后
    卡处于 IDLE(0)/STBY(2) 状态，导致永远返回 BUSY → f_mount
    报 FR_NOT_READY。
    修正：SENDING/RECEIVING/PROGRAMMING 为 BUSY，其余为 OK。
    2. 4-bit 总线失败后增加 HAL_SD_Init() 重新初始化：
    4-bit 配置失败时 SDMMC 外设残留错误状态，直接切 1-bit
    可能因外设状态不干净而失败。重新初始化确保干净状态。
2026-06-03 debug: SD 初始化逐步诊断打印
    在 BSP_SD_Init 各阶段打印返回值和错误码：
    - HAL_SD_Init 的 ret/state/ErrorCode
    - 4-bit ConfigWideBusOperation 的 ret/ErrorCode
    - 1-bit fallback 的 ret/ErrorCode
    用于定位 4-bit 失败后 1-bit 回退仍然失败的根因。
2026-06-03 fix: SD 4-bit 失败后不再重新初始化，默认 1-bit 模式
    诊断日志显示：4-bit ConfigWideBusOperation 失败后，调用 HAL_SD_Init
    重新初始化（发 CMD0 重置卡），再尝试 1-bit 也报 CMD_CRC_FAIL。
    根因：CMD0 重置后整个初始化序列重跑，但 SDMMC 外设/卡状态异常，
    导致后续命令 CRC 校验全部失败。
    修复：4-bit 失败后不再重新初始化，直接用 HAL_SD_Init 已配置好的
    默认 1-bit 模式。清除 ErrorCode 后返回 MSD_OK。
2026-06-04 fix: SD 4-bit 失败后恢复 SDMMC 外设总线宽度为 1-bit
    ConfigWideBusOperation 内部先将 SDMMC 外设切到 4-bit (CLKCR.WIDBUS=10)
    再发 CMD6 给卡。CMD6 CRC 失败后，外设留在 4-bit 但卡仍在 1-bit，
    导致后续 DMA 传输报 HAL_SD_ERROR_DMA (0x02000000)。
    修复：4-bit 失败后直接写 SDMMC_CLKCR 寄存器，清除 WIDBUS 位恢复
    外设为 1-bit 模式，与卡的默认状态一致。
2026-06-04 docs: 记录 SDMMC 调试第三轮（问题 28-32）
    新增十五节：参考 H743 DEMO 示例修复 SD 卡挂载问题
    - #28: SD DMA 与 D-Cache 一致性（启用 cache 维护）
    - #29: BSP_SD_GetCardState() 状态判断反转（根本原因）
    - #30: ConfigWideBusOperation 先改外设后改卡（根本原因之二）
    - #31: HAL_SD_Init 重新初始化导致后续 CRC 全部失败
    - 经验总结 28-32
2026-06-04 fix: SDMMC 外设初始化缺失 + 4-bit 默认改为 1-bit + initTestTask 栈增大
    问题 33（阻塞性）：MX_SDMMC1_SD_Init() 被注释后 hsd1.Instance 始终为 NULL，
    HAL_SD_MspInit 的 Instance==SDMMC1 检查失败 → GPIO/时钟/PLL 完全未初始化 →
    随后 HAL_SD_InitCard 通过 NULL 指针访问外设寄存器 → HardFault。
    修复：在 main.c 中手动设置 hsd1.Instance=SDMMC1 + BusWide=1B + 调用 HAL_SD_MspInit。
    问题 34：BSP_SD_Init 每次启动都尝试 4-bit → CMD6 CRC 失败 → 回退，浪费 ~2 秒。
    改为仅当 Init.BusWide==SDMMC_BUS_WIDE_4B 时才尝试，1-bit 默认直接跳过。
    问题 35：initTestTask 栈 4KB 偏紧（W25QXX+SD+FATFS 内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
    [main.c]
2026-06-04 fix: SDMMC1 中断未使能导致 DMA 完成回调永不触发（问题 36）
    HAL_SD_MspInit 只配了时钟/GPIO 但没有配置 NVIC，SDMMC1_IRQn 未使能。
    同时 stm32h7xx_it.c 缺少 SDMMC1_IRQHandler override。
    DMA 完成后中断不响应 → BSP_SD_ReadCpltCallback 不被调用 →
    osMessageQueueGet 30s 超时 → f_mount 返回 FR_DISK_ERR。
    修复:
    - sdmmc.c: HAL_SD_MspInit 加 HAL_NVIC_SetPriority/EnableIRQ(SDMMC1_IRQn, 6, 0)
    - stm32h7xx_it.c: 加 SDMMC1_IRQHandler → HAL_SD_IRQHandler(&hsd1)
    优先级 6 > configMAX_SYSCALL(5) → 安全区域内可调用 FreeRTOS API
    (osMessageQueuePut in callback)。
2026-06-04 fix: SD DMA 读操作前加 Cache Clean 防止 FIFO 溢出（问题 36 补充）
    问题 36 修复 NVIC 后中断能正常触发，但 SD 读操作出现新错误:
    error=32 (HAL_SD_ERROR_RX_OVERRUN) — SDMMC FIFO 溢出。
    根因: AXI SRAM 配置为 Cacheable（写回模式）。DMA 读之前
    目标 buffer 的 cache line 若有脏数据，IDMA 写入时缓存控制器
    需先写回旧数据 → 总线延迟 → FIFO 溢出。
    sd_diskio.c 原来只在读之后 Invalidate，缺少读之前的 Clean。
    现增加 SCB_CleanDCache_by_Addr 在读之前将脏 cache line 写回，
    确保 IDMA 写入无延迟。
2026-06-04 fix: SD DMA 缓冲区从 DTCM 移到 D2 SRAM（问题 37 — HardFault 根本原因）
    问题 36 修复后出现 [HARDFAULT] CFSR=0x00000400 (IMPRECISERR)。
    addr2line 定位 PC=0x080016DE 在 SD_read 的 SCB_CleanDCache_by_Addr 附近。
    根因分析: 链接脚本将所有 .bss 全局变量放在 DTCM (0x20000000)。
    DTCM 是 CPU 私有 TCM 内存，不挂在 AXI 总线上。
    SDMMC 的 IDMA 走 AXI 总线，完全无法访问 DTCM → IDMA 写入 DTCM
    地址时触发总线错误（上一版表现为 RX_OVERRUN，新版表现为 HardFault）。
    .map 文件确认:
    - SDFatFS 在 0x20000304 (DTCM)
    - ucHeap (FreeRTOS 堆) 在 0x20002648 (DTCM)
    - 所有 .bss 全局变量都在 DTCM
    修复（6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
    [sd_verify.c]
2026-06-04 docs: 记录 SDMMC 调试第六轮（问题 37-41）—— DTCM HardFault 根因
    新增 DEBUG_LOG 第十八节:
    - 问题 37: .bss 在 DTCM → SDMMC IDMA 无法访问 → IMPRECISERR HardFault
    - 问题 38: Cache Clean 分析（已澄清非故障源）
    - 经验 39: DTCM 不能用于 DMA 缓冲区
    - 经验 40: IMPRECISERR 调试策略（.map 文件检查是定位关键）
    - 经验 41: ENABLE_SCRATCH_BUFFER 隔离 DMA 与用户缓冲
    更新 CLAUDE.md:
    - MPU 配置表新增 DTCM 行
    - D2 SRAM 布局更新为实测值（含 .sd_sec 0x30004C00）
    - CubeMX 覆盖表新增 fatfs.c / sd_diskio.c / sd_verify.c
    - LWIP_RAM_HEAP_POINTER 更新为 0x30005100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
2026-06-05 debug: SDMMC1 reset + BFAR诊断输出 + 问题39日志
    [main.c]
2026-06-17 fix(sdmmc): SD write DMA timeout, cache fault on NC memory, linker overlap
    Bug 1: SD_write() scratch path waited for READ_CPLT_MSG instead of
    WRITE_CPLT_MSG -> 30s timeout on every non-aligned write. (sd_diskio.c)
    Bug 2: ENABLE_SD_DMA_CACHE_MAINTENANCE=1 called SCB_CleanDCache_by_Addr
    on D2 SRAM (Non-Cacheable) -> IMPRECISE BusFault per ARMv7-M spec.
    Disabled cache maintenance since D2 SRAM is NC. (sd_diskio.c)
    Bug 3: FreeRTOS heap 32KB insufficient for all task stacks + TCBs.
    Increased to 40KB. (FreeRTOSConfig.h)
    Bug 4: .sd_sec linker section hardcoded at 0x30004C00 could overlap
    .lwip_sec RX pool if ETH_RX_BUFFER_CNT increased. Changed to ALIGN(32)
    relative placement and added ASSERT be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
