YuElvin/stm32_canbus/(notices)

Notices in the files:
CANbus_code/Core/Src/main.c:
Copyright (c) 2026 STMicroelectronics.
All rights reserved.
This software is licensed under terms that can be found in the LICENSE file
